gabriellaraia/CIDigital-SoC-IoT/design/rtl/SoC_AXI4Lite_PicoRV32 -/PER_SPI/spi_master.v

// SPDX-License-Identifier: MIT
// SPDX-FileCopyrightText: 2021-2022 Spencer Chang

`resetall
`timescale 1ns / 1ps
`default_nettype none

module spi_master #
(
    localparam WORD_COUNTER_WIDTH = $clog2(AXIS_DATA_WIDTH) + 1,
    parameter AXIS_DATA_WIDTH = 8,
    parameter PRESCALE_WIDTH = 8
)
(
    input  wire                         clk,
    input  wire                         rst,

    /*
     * AXIS Input
     */
    input  wire [AXIS_DATA_WIDTH-1:0]   s_axis_tdata,
    input  wire                         s_axis_tvalid,
    output wire                         s_axis_tready,

    /*
     * AXIS Output
     */
    output wire [AXIS_DATA_WIDTH-1:0]   m_axis_tdata,
    output wire                         m_axis_tvalid,
    input  wire                         m_axis_tready,

    /*
     * SPI
     */
    output wire                         sclk_o,
    output wire                         sclk_t,
    output wire                         mosi_o,
    output wire                         mosi_t,
    input  wire                         miso,

    /*
     * Configuration
     */
    input  wire                             enable,

    input  wire                             lsb_first,
    input  wire [1:0]                       spi_mode,
    input  wire [PRESCALE_WIDTH-1:0]        sclk_prescale,
    input  wire [WORD_COUNTER_WIDTH-1:0]    spi_word_width,

    /*
     * Status
     */
    output wire                         rx_overrun_error,
    output wire                         bus_active
);



localparam MASTER_STATE_IDLE = 2'b00;
localparam MASTER_STATE_TRANSFER = 2'b01;
localparam MASTER_STATE_TX_COMPLETE = 2'b10;
reg [1:0] master_state = MASTER_STATE_IDLE;

// axis
reg [AXIS_DATA_WIDTH-1:0] m_axis_tdata_reg = 0;
reg m_axis_tvalid_reg = 0;
assign m_axis_tdata = m_axis_tdata_reg;
assign m_axis_tvalid = m_axis_tvalid_reg;
assign s_axis_tready = ((master_state == MASTER_STATE_IDLE) && enable);

// mosi
reg mosi_reg = 0;
reg miso_reg = 0;
assign mosi_o = mosi_reg;
assign mosi_t = mosi_reg;

// status
reg rx_overrun_error_reg = 0;
reg active = 0;
assign bus_active = (master_state != MASTER_STATE_IDLE);
assign rx_overrun_error = rx_overrun_error_reg;

// lsb first
reg lsb_first_buff;

// spi mode
reg [1:0] spi_mode_buff;
wire cpol, cpha;
assign cpol = (spi_mode_buff === 2) | (spi_mode_buff === 3);
assign cpha = (spi_mode_buff === 1) | (spi_mode_buff === 3);

// spi word length
reg [WORD_COUNTER_WIDTH-1:0] spi_word_width_buff = AXIS_DATA_WIDTH;
reg [WORD_COUNTER_WIDTH-1:0] bit_out_cnt = 0;
reg [WORD_COUNTER_WIDTH-1:0] bit_in_cnt = 0;

// spi transaction contents
reg [AXIS_DATA_WIDTH-1:0] data_o_reg = 0;
reg [AXIS_DATA_WIDTH-1:0] data_i_reg = 0;

// generate sclk signal
wire sclk_en;
assign sclk_en = (master_state != MASTER_STATE_IDLE);

reg [PRESCALE_WIDTH-1:0] sclk_prescale_buff;
reg [PRESCALE_WIDTH-1:0] prescale_counter;

reg sclk_buff = 0;
assign sclk_o = sclk_buff;
assign sclk_t = sclk_buff;

// keep track of edges
reg sclk_last;
wire sclk_read_edge;
wire sclk_write_edge;
wire sclk_rising_edge;
wire sclk_falling_edge;

// cpha = 0 means read on first edge
// cpha = 1 means read on second edge
// POL0, PHA0 sample on rising
// POL0, PHA1 sample on falling
// POL1, PHA0 sample on falling
// POL1, PHA1 sample on rising
assign sclk_read_edge = (cpha ^ cpol) ? sclk_falling_edge : sclk_rising_edge;
assign sclk_write_edge = (cpha ^ cpol) ? sclk_rising_edge : sclk_falling_edge;
assign sclk_rising_edge = (~sclk_last & sclk_o);
assign sclk_falling_edge = (sclk_last & ~sclk_o);

always @(posedge clk) begin // proc_sclk_gen
    if (rst) begin
        prescale_counter <= 0;
        sclk_last <= 0;
    end else begin
        if (sclk_en) begin
            prescale_counter <= prescale_counter + 1;
            // divide by 4 to account for inherent clock division in scheme
            if (prescale_counter == sclk_prescale_buff >> 2) begin
                sclk_buff <= !sclk_buff;
                prescale_counter <= 0;
            end
        end else begin
            // let the sclk idle according to the polarity
            sclk_buff <= cpol;
            prescale_counter <= 0;
        end
        sclk_last <= sclk_o;
    end
end // end proc_sclk_gen

// perform an spi transaction
always @(posedge clk) begin // proc_spi_transaction
    if (rst) begin
        master_state <= MASTER_STATE_IDLE;
        mosi_reg <= 0;
        data_i_reg <= 0;
        rx_overrun_error_reg <= 0;
        m_axis_tvalid_reg <= 1'b0;
    end else begin
        miso_reg <= miso;

        // handle an axis transaction
        if (m_axis_tvalid && m_axis_tready) begin
            m_axis_tvalid_reg <= 0;
            rx_overrun_error_reg <= 0;
        end

        // state machine
        case (master_state)
            MASTER_STATE_IDLE: begin
                if (enable && s_axis_tvalid && s_axis_tready) begin
                    // configurable inputs
                    spi_mode_buff <= spi_mode;
                    spi_word_width_buff <= spi_word_width;
                    sclk_prescale_buff <= sclk_prescale;
                    lsb_first_buff <= lsb_first;

                    data_o_reg <= s_axis_tdata;
                    data_i_reg <= 0;

                    bit_in_cnt <= 0;
                    bit_out_cnt <= 0;
                    master_state <= MASTER_STATE_TRANSFER;
                end
            end
            MASTER_STATE_TRANSFER: begin
                // for cpha = 0, the rising edge is sampling, so we must prepare data on the wire
                // before we see any clocks (as soon as we transition to the transfer state)
                if ((~cpha) && (bit_out_cnt==0)) begin
                    if (lsb_first_buff) begin
                        mosi_reg <= data_o_reg[0];
                        data_o_reg <= data_o_reg >> 1;
                    end else begin
                        mosi_reg <= data_o_reg[spi_word_width_buff - 1];
                        data_o_reg <= data_o_reg << 1;
                    end
                    bit_out_cnt <= bit_out_cnt + 1;
                end

                // read stage
                if (sclk_read_edge) begin
                    if (lsb_first_buff) begin
                        // note that if the spi word is shorter, this will be aligned left
                        data_i_reg <= {miso_reg, data_i_reg[AXIS_DATA_WIDTH-1:1]};
                    end else begin
                        data_i_reg <= {data_i_reg[AXIS_DATA_WIDTH-2:0], miso_reg};
                    end
                    bit_in_cnt <= bit_in_cnt + 1;
                end

                // write stage
                if (sclk_write_edge) begin

                    if (lsb_first_buff) begin
                        mosi_reg <= data_o_reg[0];
                        data_o_reg <= data_o_reg >> 1;
                    end else begin
                        mosi_reg <= data_o_reg[spi_word_width_buff - 1];
                        data_o_reg <= data_o_reg << 1;
                    end
                    bit_out_cnt <= bit_out_cnt + 1;
                end

                // the last step of spi transaction in any mode is a read
                // so we will check for done by doing a spi read
                if (bit_in_cnt == spi_word_width_buff) begin
                    master_state <= MASTER_STATE_TX_COMPLETE;

                    // write data back to axis
                    m_axis_tvalid_reg <= 1;

                    // align the data to the right
                    if (lsb_first_buff) begin
                        m_axis_tdata_reg <= data_i_reg >> (AXIS_DATA_WIDTH - spi_word_width);
                    end else begin
                        m_axis_tdata_reg <= data_i_reg;
                    end
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
